langrfrantisek/HzF_voting_system/Photos/PCB_connected.jpg

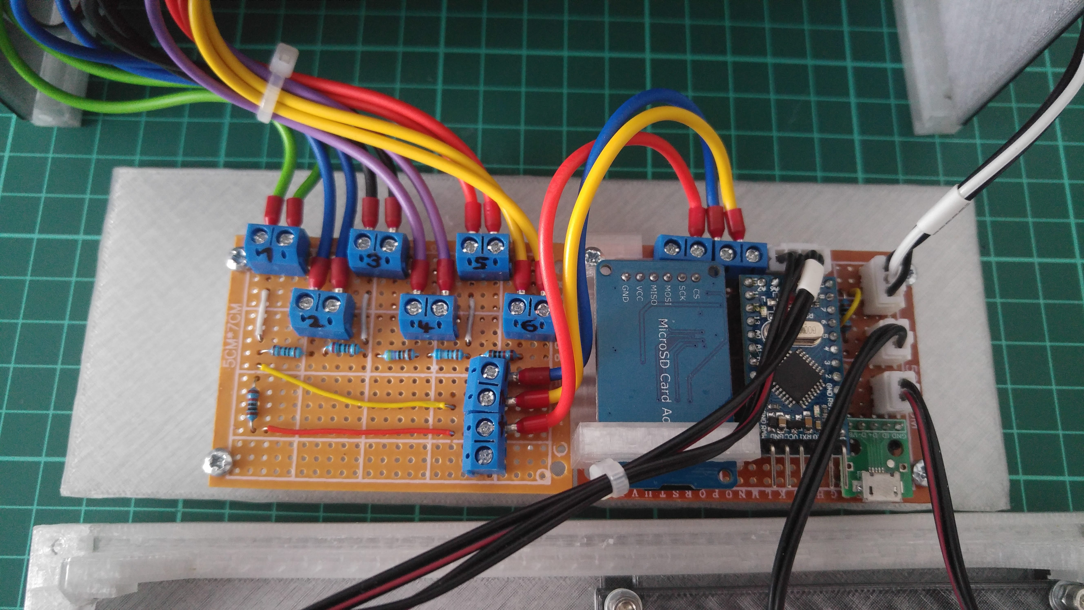
Photos/PCB_connected.jpg
