langrfrantisek/HzF_voting_system/HzF_flowchart.pdf

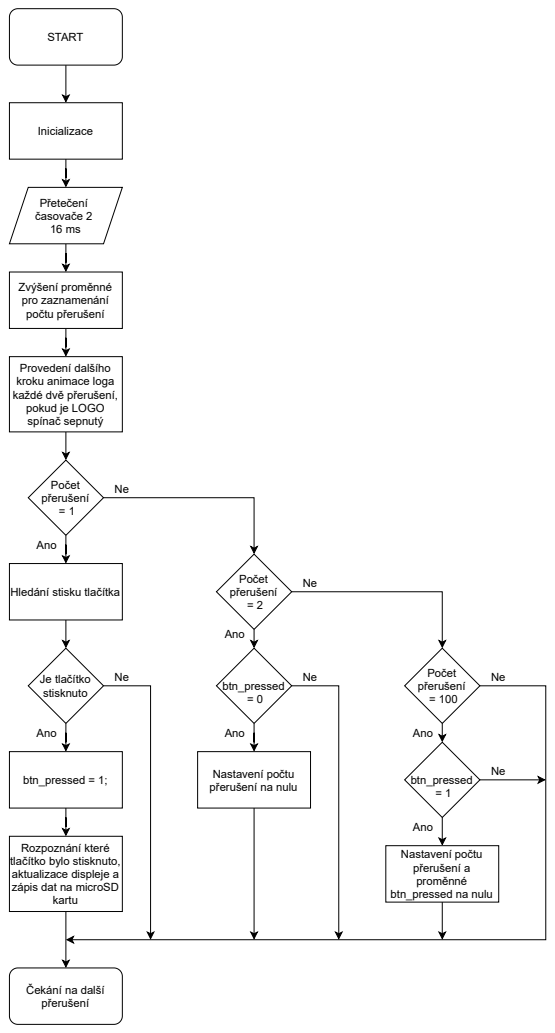
[picture p16: page 1]
START; Inicializace; Počet přerušení = 1; Přetečení časovače 2 16 ms; Zvýšení proměnné pro zaznamenání počtu přerušení; Počet přerušení = 2; btn_pressed = 0; Je tlačítko stisknuto; Ano; kartu; Počet přerušení = 100; btn_pressed = 1;; btn_pressed; Nastavení počtu přerušení a proměnné btn_pressed na nulu

Provedení dalšího
kroku animace loga
každé dvě přerušení,
pokud je LOGO
spínač sepnutý

Hledání stisku tlačítka

Nastavení počtu
přerušení na nulu

Rozpoznání které
tlačítko bylo stisknuto,
aktualizace displeje a
zápis dat na microSD

Čekání na další
přerušení
