langrfrantisek/HzF_voting_system/(commit log)

2021-08-07 LOGO switch basic function
2021-08-07 logo switch turns animation on/off
2021-08-07 logo animation works even if button is pressed
2021-08-10 circle animation almost works but buttons don't
2021-08-18 flowchart pdf
2021-08-22 all STLs for 3D print added
2022-09-18 load last stored votes when powerd up
